Scopeuk/GroundedDeltaDeskToy/params.scad

pinDia = 5;
pinClearence = 0.3;
//reduced tolerence for parts printed in ideal orientation
pinClearenceVert = 0.2;
