Scopeuk/GroundedDeltaDeskToy/Images/FirstPrint.jpg

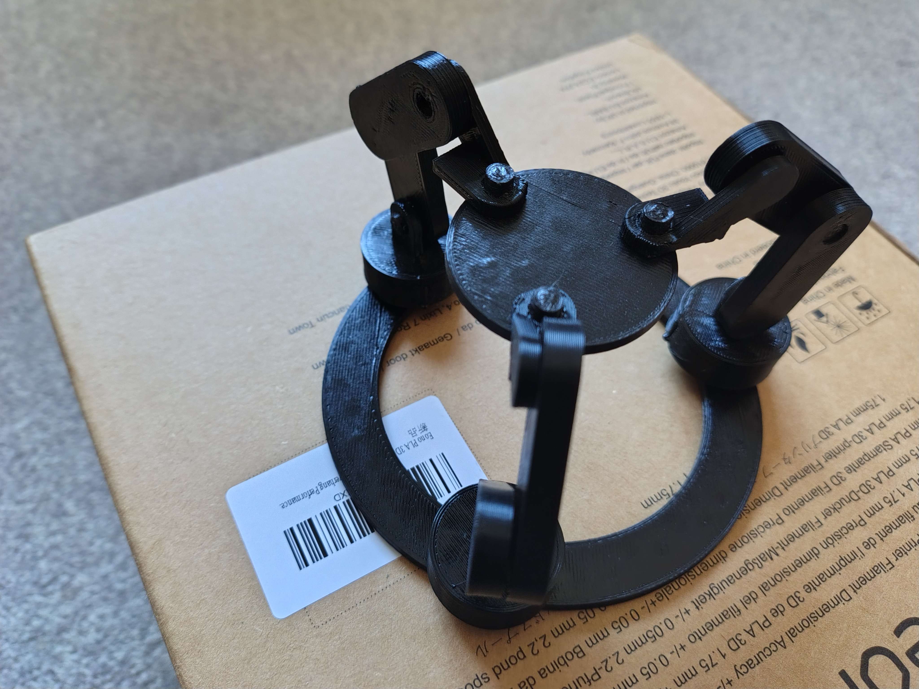
Images/FirstPrint.jpg
