Scopeuk/GroundedDeltaDeskToy/(commit log)

2025-05-16 initial model as printed 14/05/2025 known issues, base pins are a little loose tool to wrist has not been tested
    [arm.scad, base.scad, params.scad, shoulder.scad, tool.scad, wrist.scad]
2025-05-16 ignore generated stl files
2025-05-16 Migrate printList to README and tidy up.
    Add an image to the landing page
2025-05-16 printing notes detail print orientation and support requirements
2025-05-16 Generate pin joined version of the model. All joining pins are separate to the joined parts. Create Pin.scad which defines a pin part, a clearance part for the moving end of the joint and a mate part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
    [Pin.scad, arm.scad, pinDemo.scad, shoulder.scad, tool.scad, wrist.scad]
2025-05-17 Fix include capitalization
    [shoulder.scad, tool.scad, wrist.scad]
2025-05-17 Add a chamfer to the end of the pin to make it easier to locate during assembly
    [Pin.scad]
2025-05-18 Doc updates Add guidance on getting the stls document how the pins work
    [pinDemo.scad]
2025-05-18 Correct read me typo
    806 > 608 for bearing in bom
2025-05-18 Read me typographical fix
    806 -> 608 bearing
2025-05-23 Update wrist design Swap pinning direction to bring centre line of joint to tool closer to centre line of arm. Update image of pinned design
    [wrist.scad]
2025-07-05 Update readme.md
    Finalise making the pegged joint varient the mainline. Tidy up ci comments to remove branch reference.
